Toaz68/ESP32-IoT-Air-Quality-Monitor/(commit log)

2026-09-27 Update PCB image and add schematic image in README
2026-09-27 Fix image file extension for schematic in README
